drmcnelson/TCD1304-Sensor-Device-with-Linear-Response-and-16-Bit-Differential-ADC/Images/Analog_RedLED_4.0V_SH0.2usec_ICG2.6usec_0pulses.260106.carryover.jpg

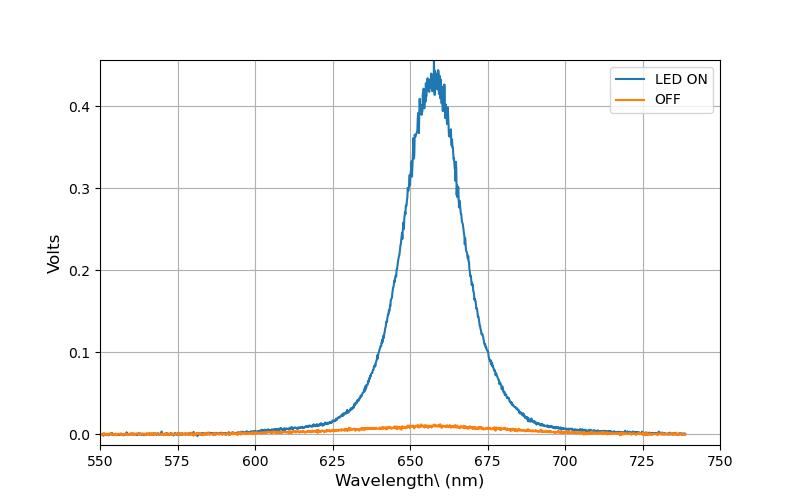
Images/Analog_RedLED_4.0V_SH0.2usec_ICG2.6usec_0pulses.260106.carryover.jpg
