drmcnelson/TCD1304-Sensor-Device-with-Linear-Response-and-16-Bit-Differential-ADC/Images/BJT_followers_Cload_Switched_Curves_Xd-out.jpg

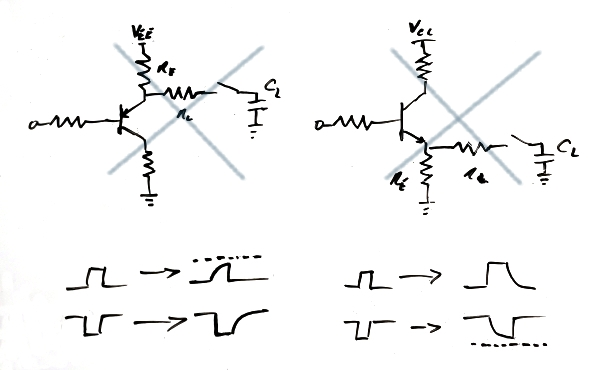
Images/BJT_followers_Cload_Switched_Curves_Xd-out.jpg
