drmcnelson/TCD1304-Sensor-Device-with-Linear-Response-and-16-Bit-Differential-ADC/Images/Carryover_pulse_voltage_all.jpg

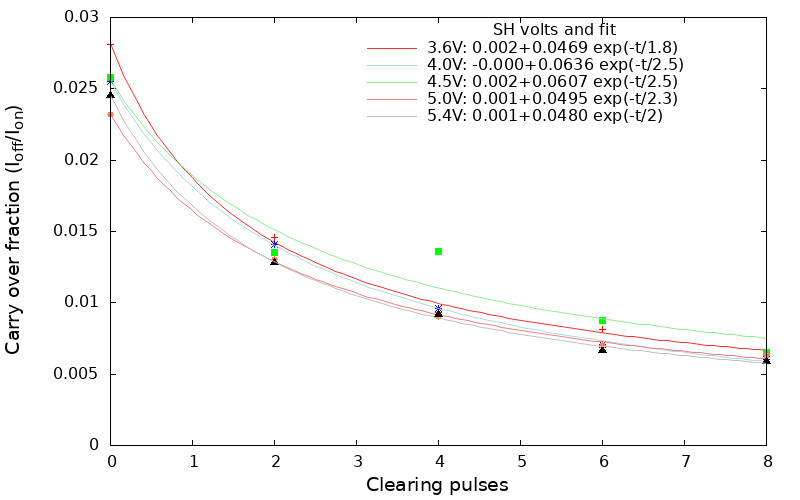
Images/Carryover_pulse_voltage_all.jpg
