drmcnelson/TCD1304-Sensor-Device-with-Linear-Response-and-16-Bit-Differential-ADC/Images/CarryOver_PulseWidth.jpg

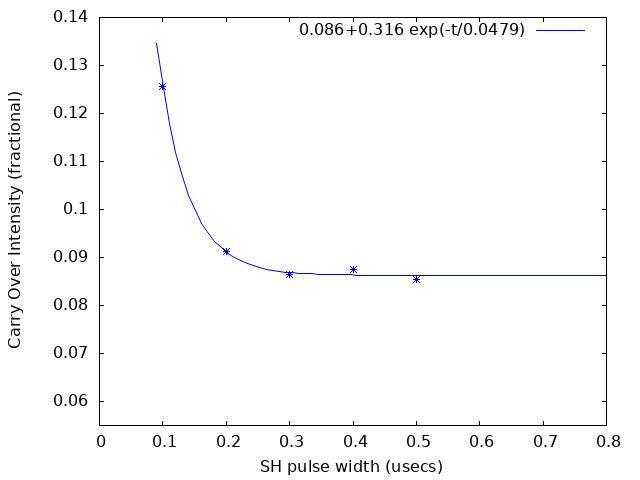
Images/CarryOver_PulseWidth.jpg
