drmcnelson/TCD1304-Sensor-Device-with-Linear-Response-and-16-Bit-Differential-ADC/Images/Carryover_time_voltage.jpg

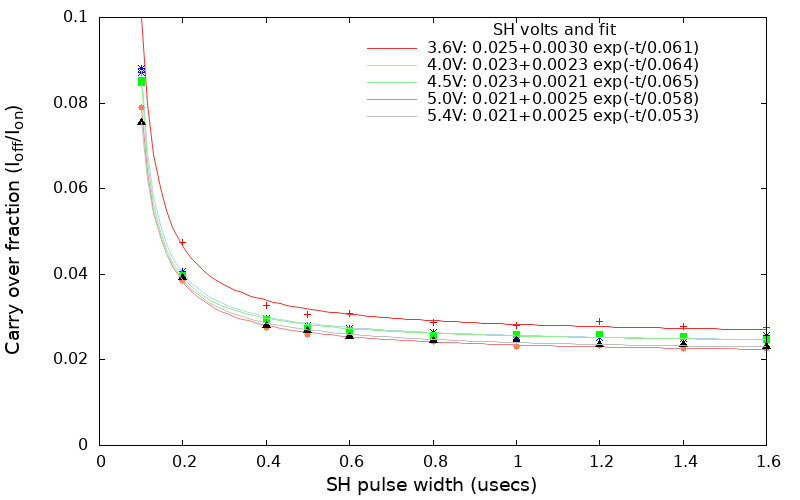
Images/Carryover_time_voltage.jpg
