drmcnelson/TCD1304-Sensor-Device-with-Linear-Response-and-16-Bit-Differential-ADC/Images/CCD-4cycle-diagram.jpg

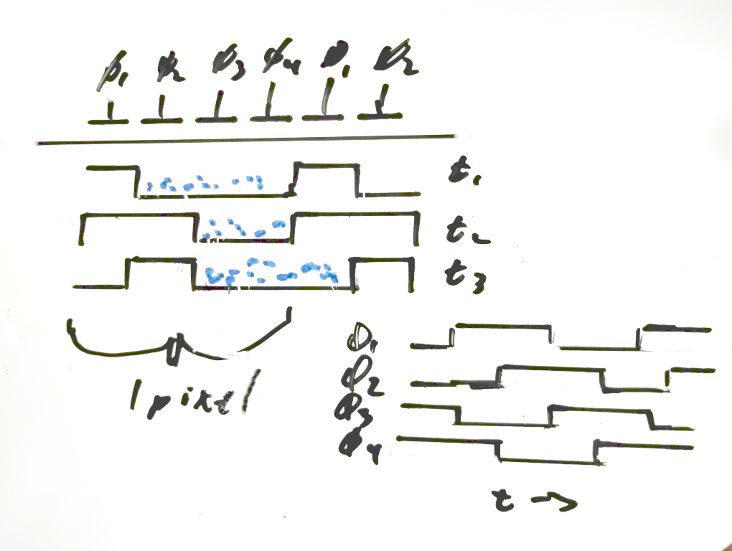
Images/CCD-4cycle-diagram.jpg
