drmcnelson/TCD1304-Sensor-Device-with-Linear-Response-and-16-Bit-Differential-ADC/Images/Comparison_responses_all.jpg

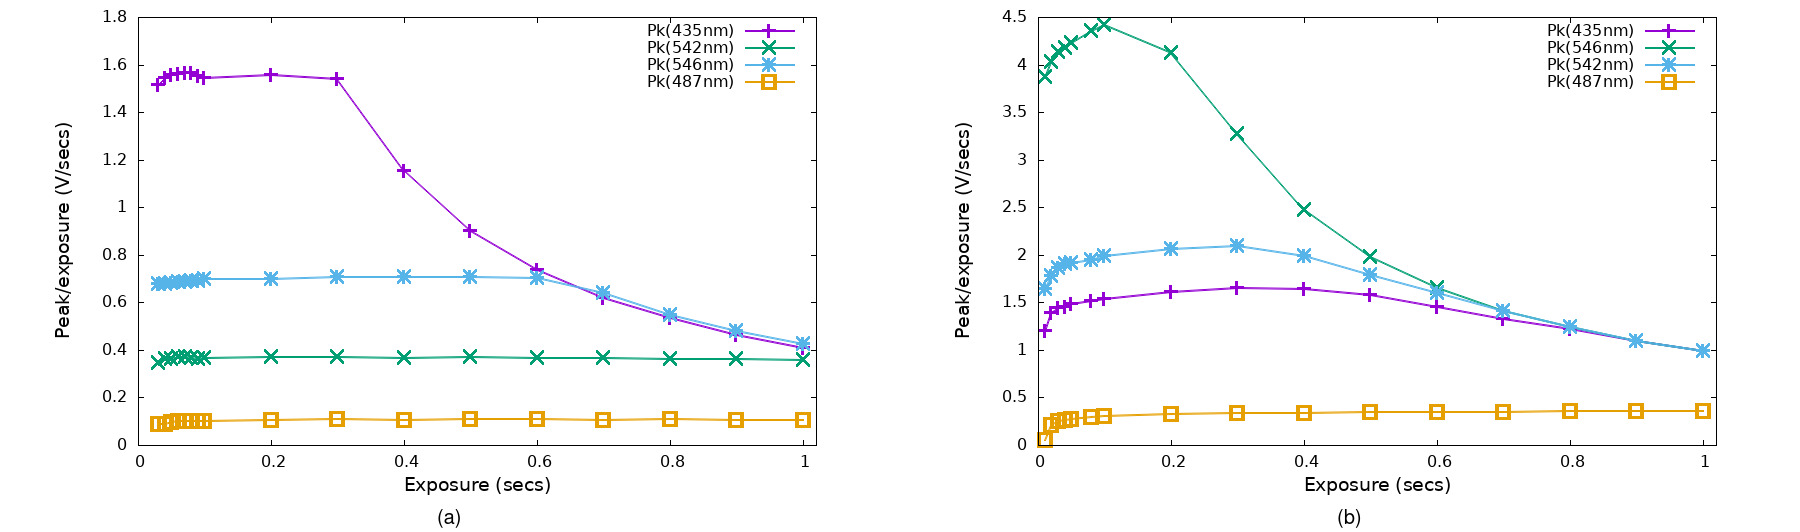
Images/Comparison_responses_all.jpg
