drmcnelson/TCD1304-Sensor-Device-with-Linear-Response-and-16-Bit-Differential-ADC/Images/Comparison_TCD1304_ND1200_Flame-S_ND1500_peaks_ratios542nm_1sec.jpg

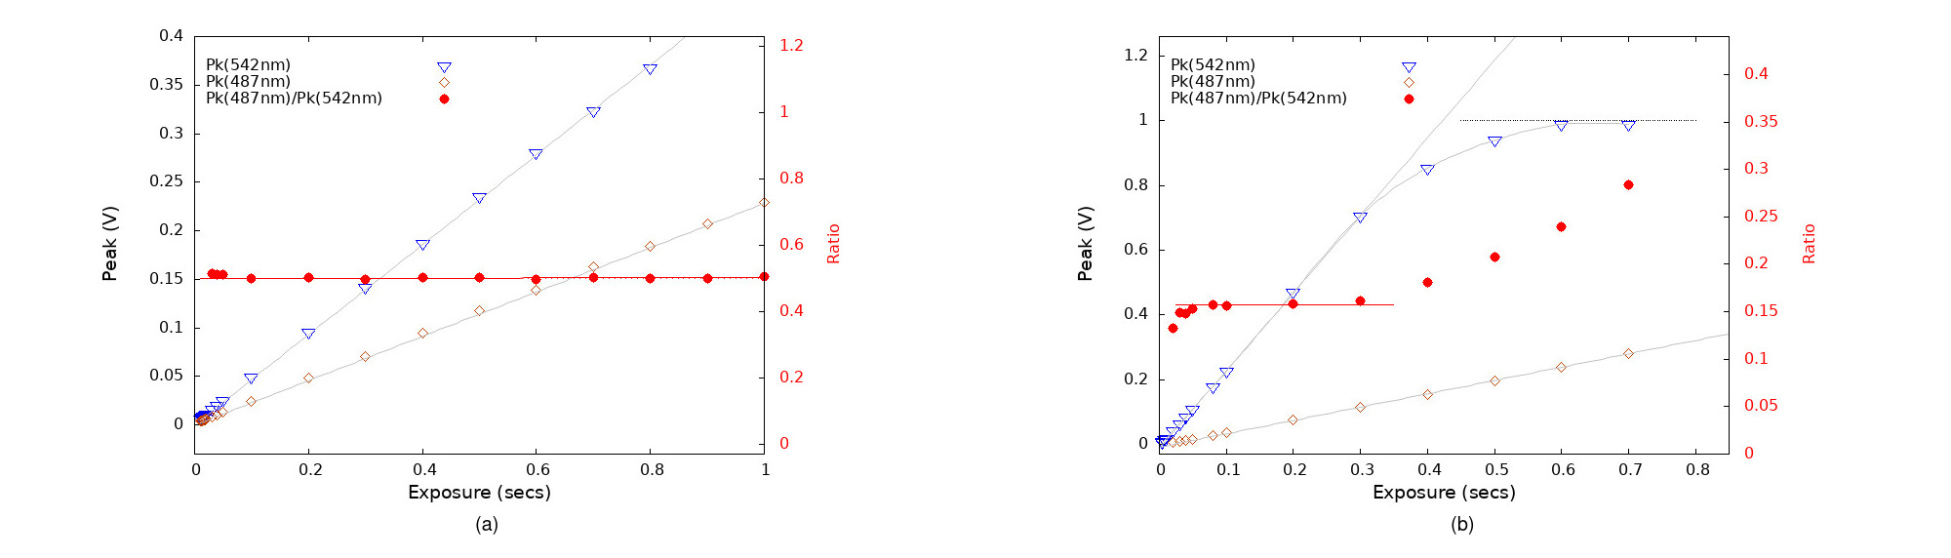
Images/Comparison_TCD1304_ND1200_Flame-S_ND1500_peaks_ratios542nm_1sec.jpg
