drmcnelson/TCD1304-Sensor-Device-with-Linear-Response-and-16-Bit-Differential-ADC/Images/DarkN810_PIT_CLK1e-06sec_CP10_3.jpg

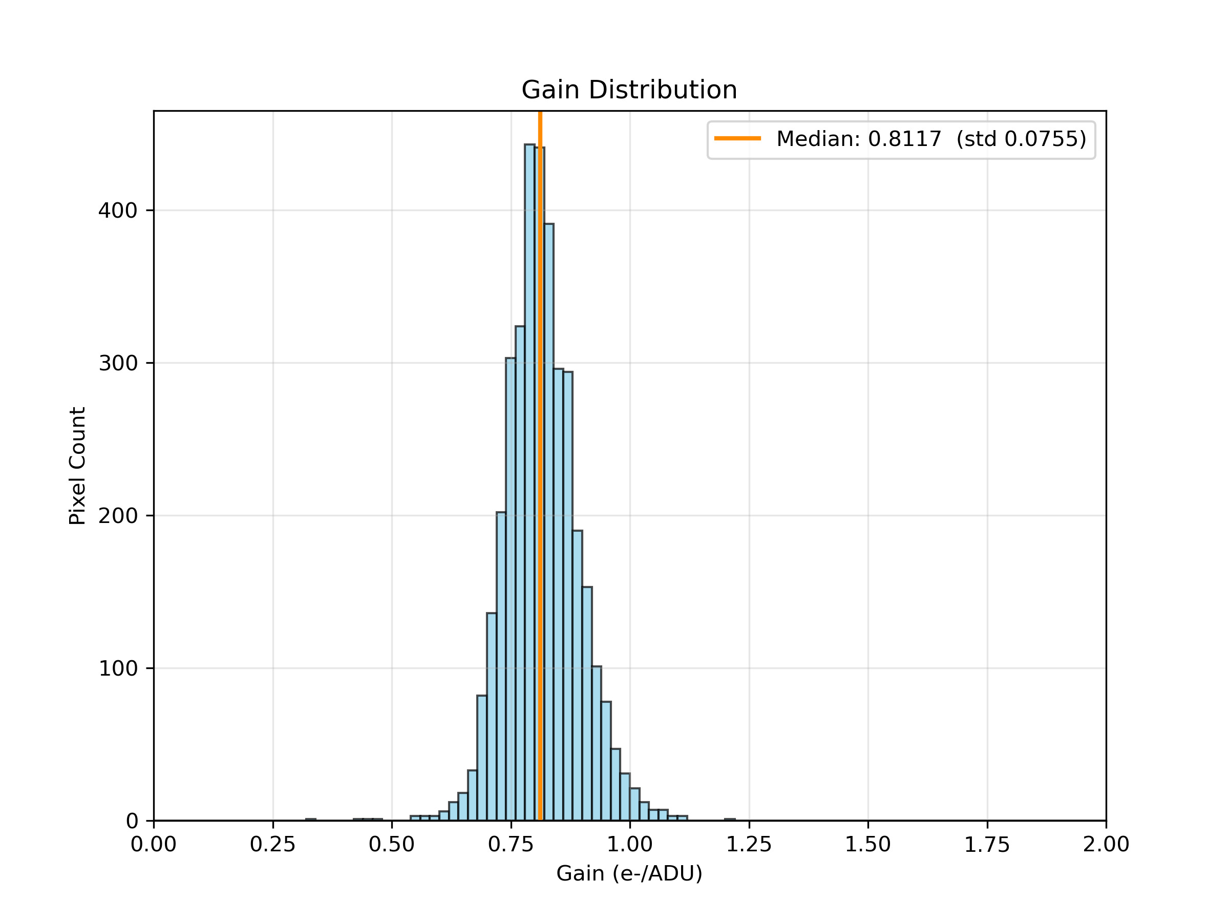
Images/DarkN810_PIT_CLK1e-06sec_CP10_3.jpg
