drmcnelson/TCD1304-Sensor-Device-with-Linear-Response-and-16-Bit-Differential-ADC/Images/DeskLamp_ND12oclock_0.05secs.seabreeze.raw.jpg

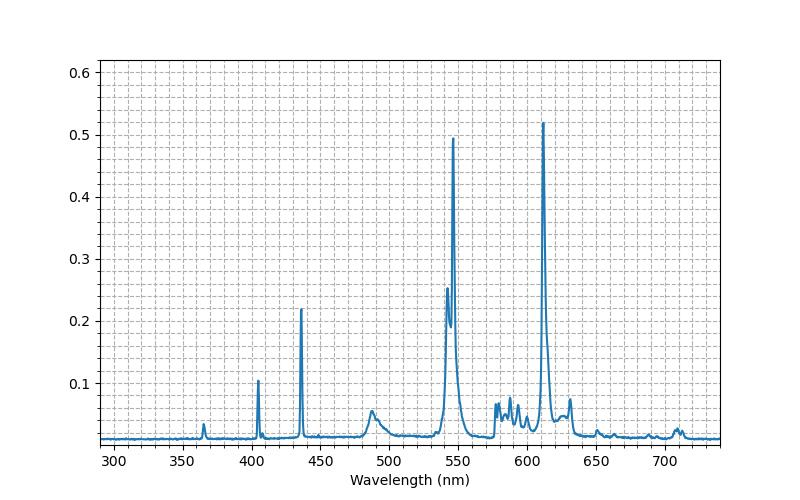
Images/DeskLamp_ND12oclock_0.05secs.seabreeze.raw.jpg
