drmcnelson/TCD1304-Sensor-Device-with-Linear-Response-and-16-Bit-Differential-ADC/Images/Fl_0.02s_frameset64.20250710.101229.398269.lccd.raw.jpg

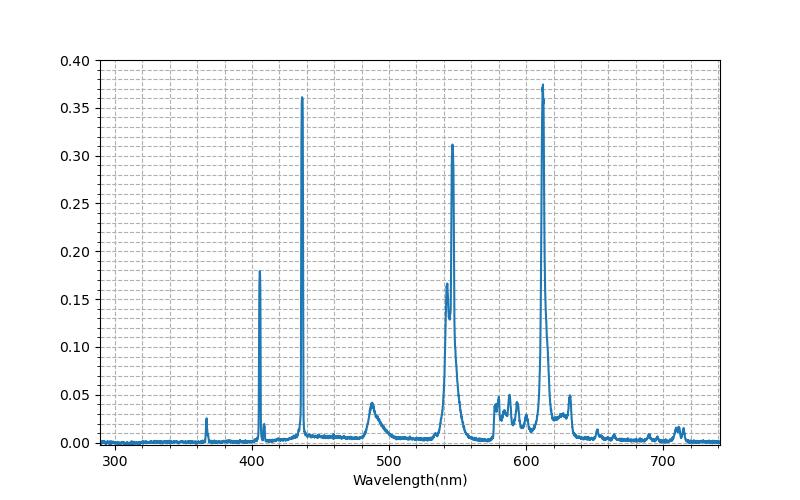
Images/Fl_0.02s_frameset64.20250710.101229.398269.lccd.raw.jpg
