drmcnelson/TCD1304-Sensor-Device-with-Linear-Response-and-16-Bit-Differential-ADC/Images/Flame-S/Flame-S_ND1500_Selected3.png

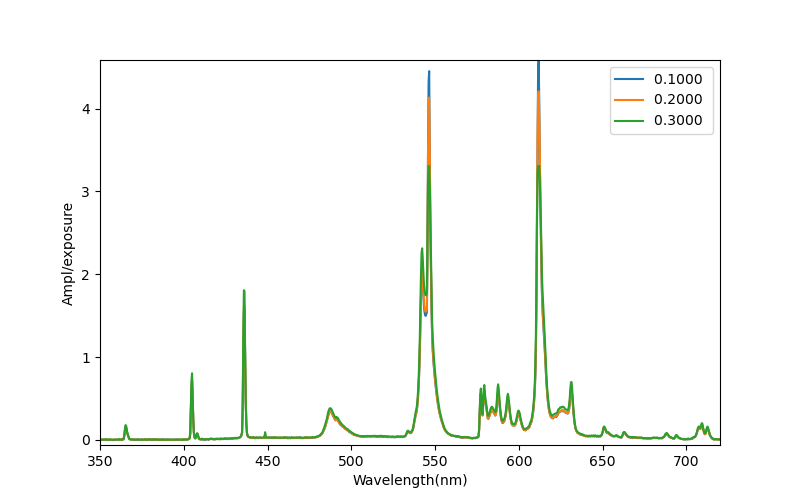
Images/Flame-S/Flame-S_ND1500_Selected3.png
