drmcnelson/TCD1304-Sensor-Device-with-Linear-Response-and-16-Bit-Differential-ADC/Images/Flame-S_ND3oclock_all.ratios_normalized.png

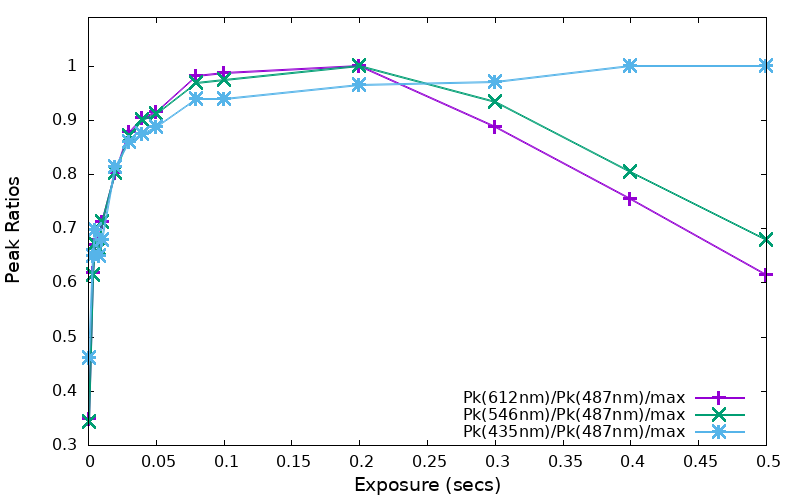
Images/Flame-S_ND3oclock_all.ratios_normalized.png
