drmcnelson/TCD1304-Sensor-Device-with-Linear-Response-and-16-Bit-Differential-ADC/Images/GreenLED_PLM_CLK6e-07sec_to_0.5sec_N110.linearity_min_adu2000_3.jpg

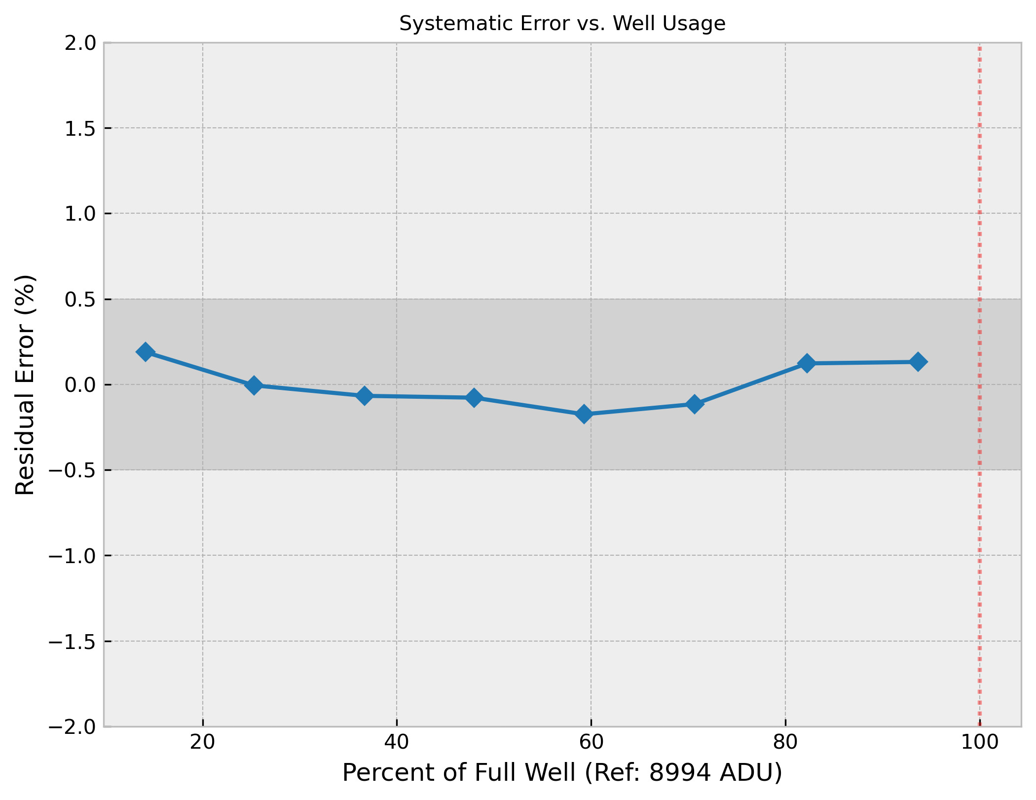
Images/GreenLED_PLM_CLK6e-07sec_to_0.5sec_N110.linearity_min_adu2000_3.jpg
