drmcnelson/TCD1304-Sensor-Device-with-Linear-Response-and-16-Bit-Differential-ADC/Images/LinearResponseComparison.jpg

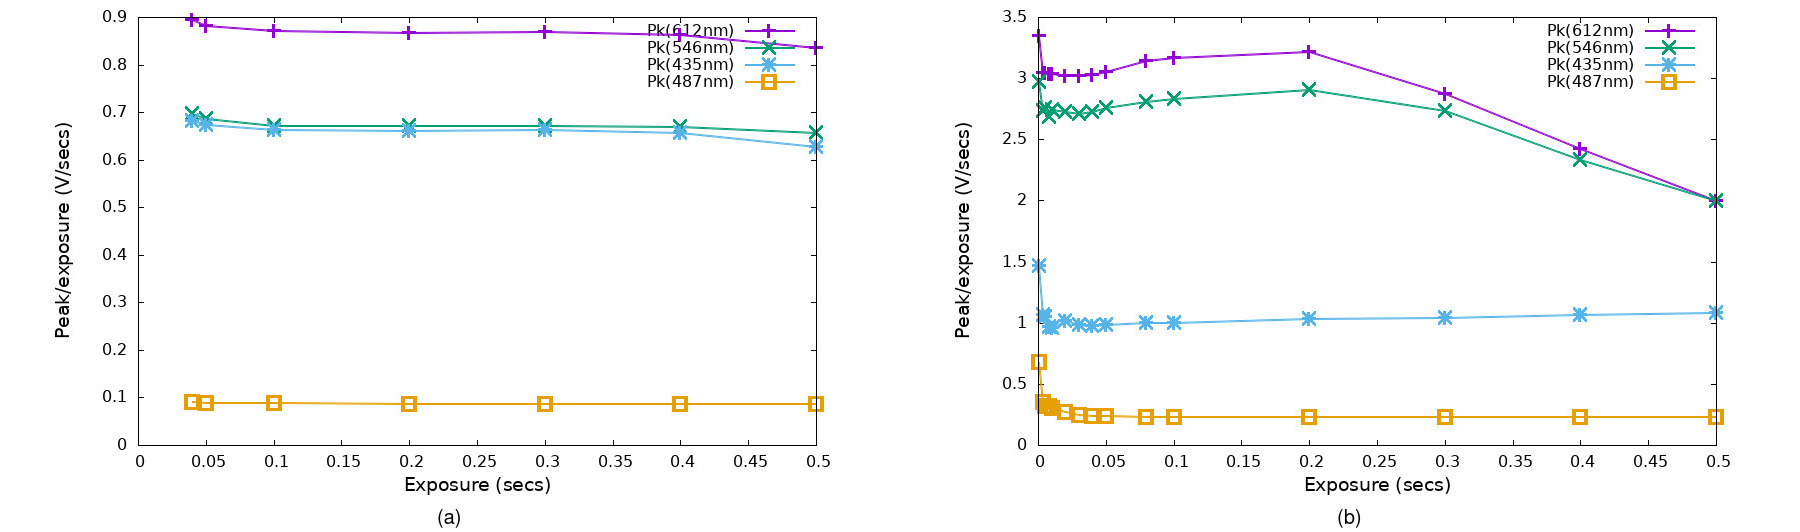
Images/LinearResponseComparison.jpg
