drmcnelson/TCD1304-Sensor-Device-with-Linear-Response-and-16-Bit-Differential-ADC/Images/PeakRatioseComparison.jpg

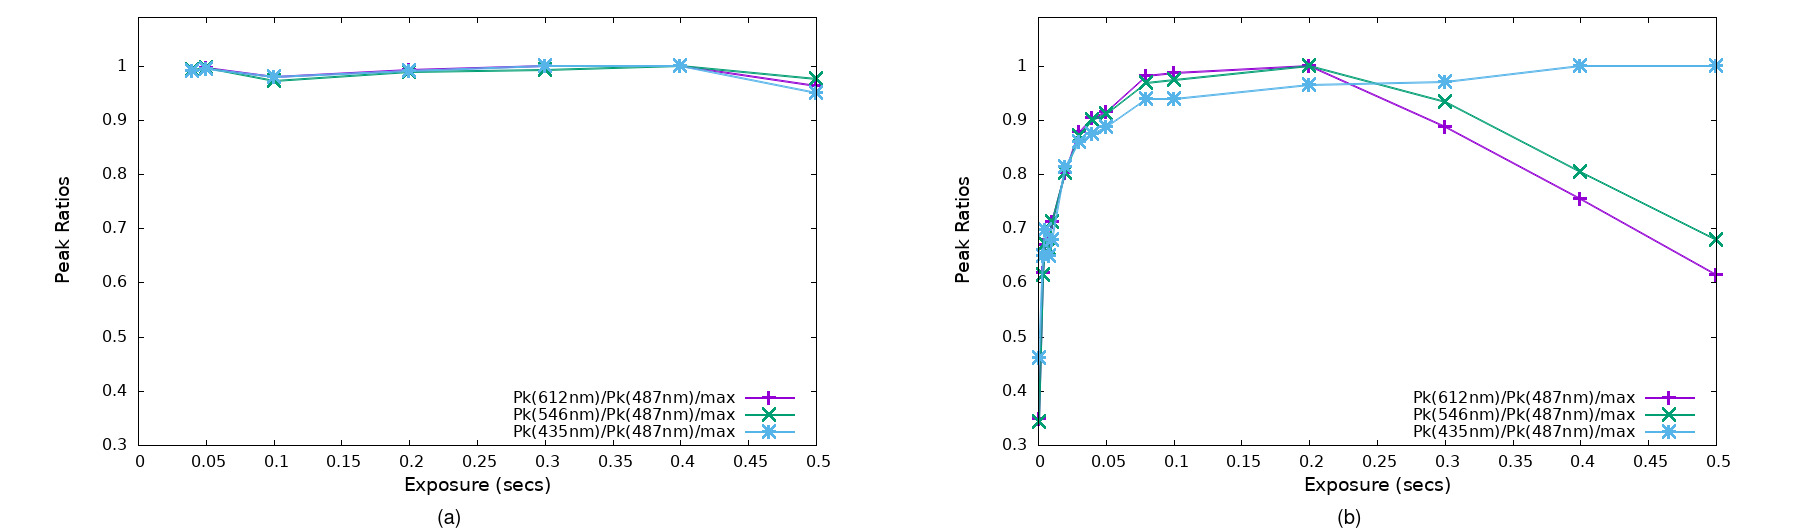
Images/PeakRatioseComparison.jpg
