drmcnelson/TCD1304-Sensor-Device-with-Linear-Response-and-16-Bit-Differential-ADC/Images/pulsewidth_study_0.2us.20250918.131309.022768.lccd.jpg

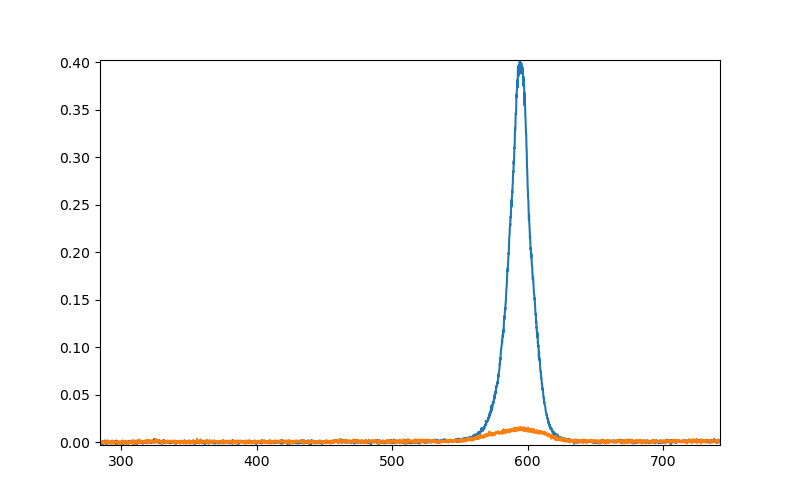
Images/pulsewidth_study_0.2us.20250918.131309.022768.lccd.jpg
