drmcnelson/TCD1304-Sensor-Device-with-Linear-Response-and-16-Bit-Differential-ADC/Images/Ringing_SensorScale_260127.jpg

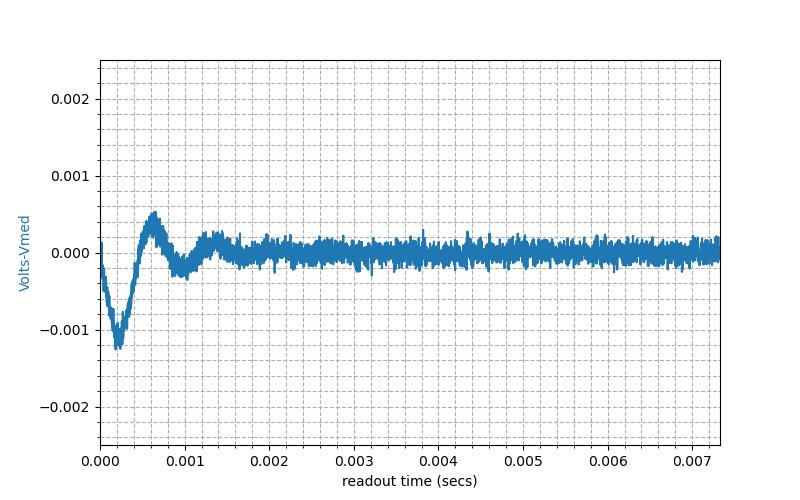
Images/Ringing_SensorScale_260127.jpg
