drmcnelson/TCD1304-Sensor-Device-with-Linear-Response-and-16-Bit-Differential-ADC/Images/RinginGone_clk0.6usec_SensorScale_260415.jpg

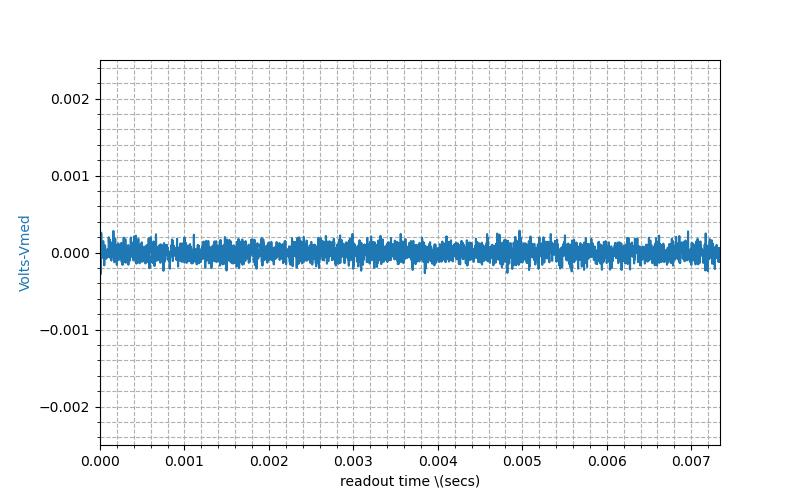
Images/RinginGone_clk0.6usec_SensorScale_260415.jpg
