drmcnelson/TCD1304-Sensor-Device-with-Linear-Response-and-16-Bit-Differential-ADC/Images/Spectrum_Flip_Shift_RC_SAR.jpg

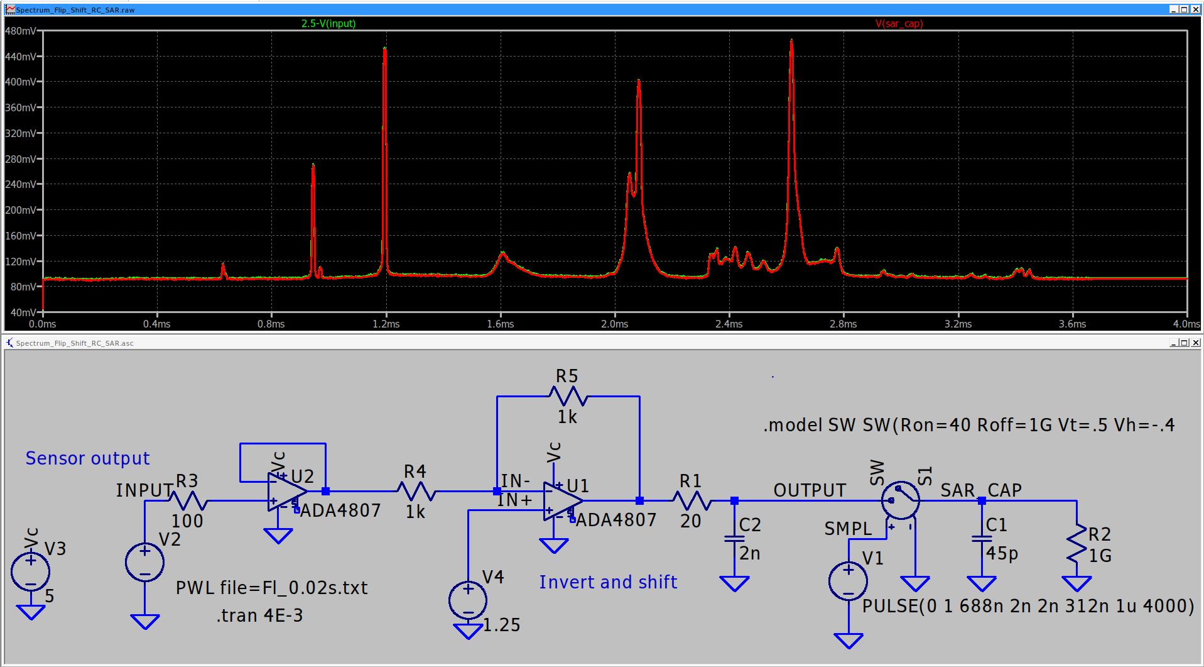
Images/Spectrum_Flip_Shift_RC_SAR.jpg
