drmcnelson/TCD1304-Sensor-Device-with-Linear-Response-and-16-Bit-Differential-ADC/Images/TCD1304_Fluorescent_ND0400.raw_peaks_ratios546nm_0.001sec.jpg

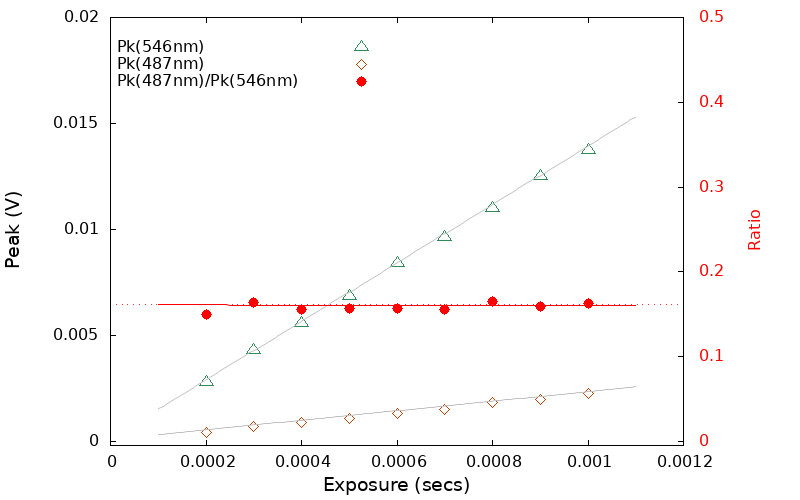
Images/TCD1304_Fluorescent_ND0400.raw_peaks_ratios546nm_0.001sec.jpg
