drmcnelson/TCD1304-Sensor-Device-with-Linear-Response-and-16-Bit-Differential-ADC/Images/TCD1304_ND12oclock_timer_all.ratios_normalized.png

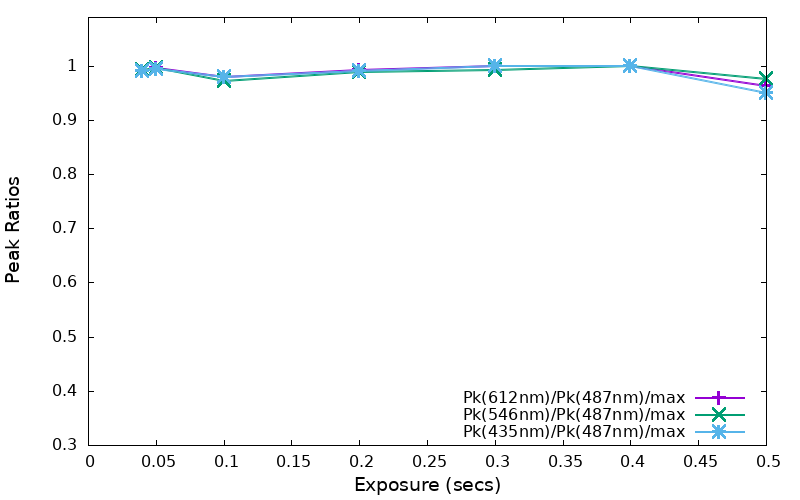
Images/TCD1304_ND12oclock_timer_all.ratios_normalized.png
