drmcnelson/TCD1304-Sensor-Device-with-Linear-Response-and-16-Bit-Differential-ADC/Images/TCD1304DG_E_250219-06.jpg

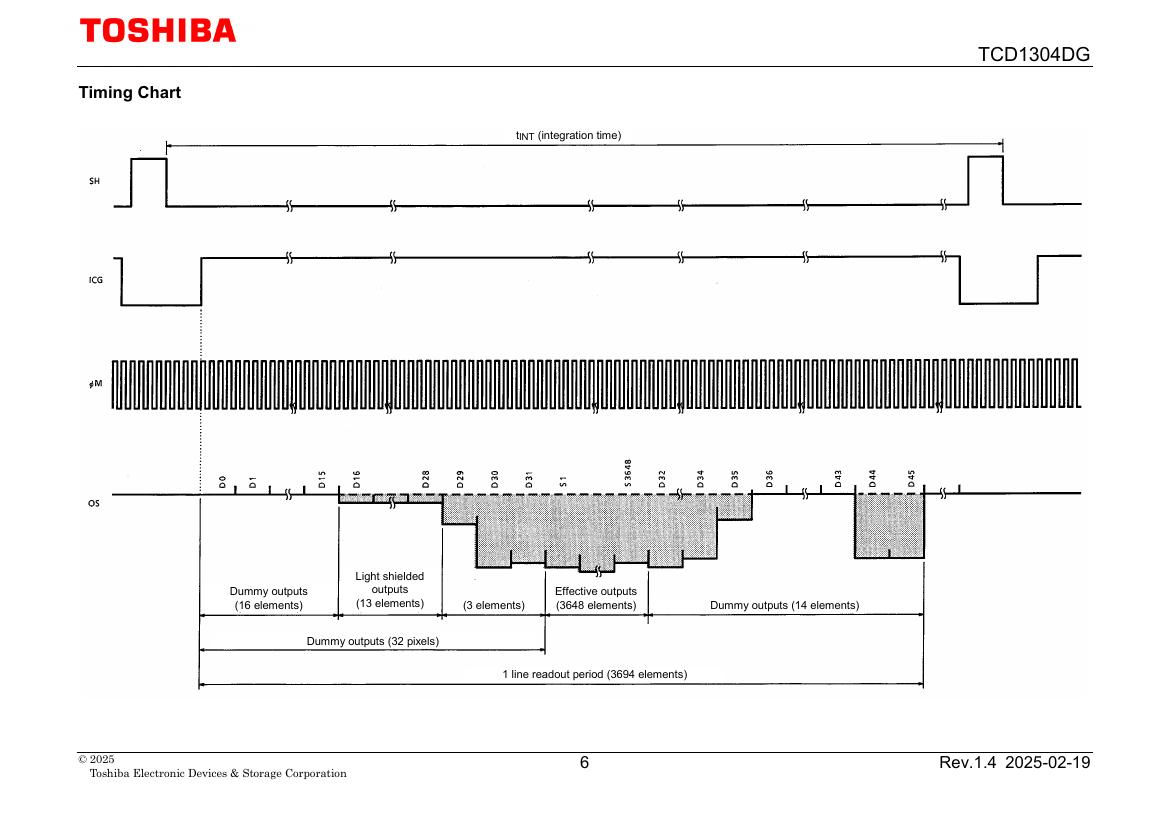
Images/TCD1304DG_E_250219-06.jpg
