drmcnelson/TCD1304-Sensor-Device-with-Linear-Response-and-16-Bit-Differential-ADC/Images/TheNewInstrument/TheNewSpectrometer_overlays.png

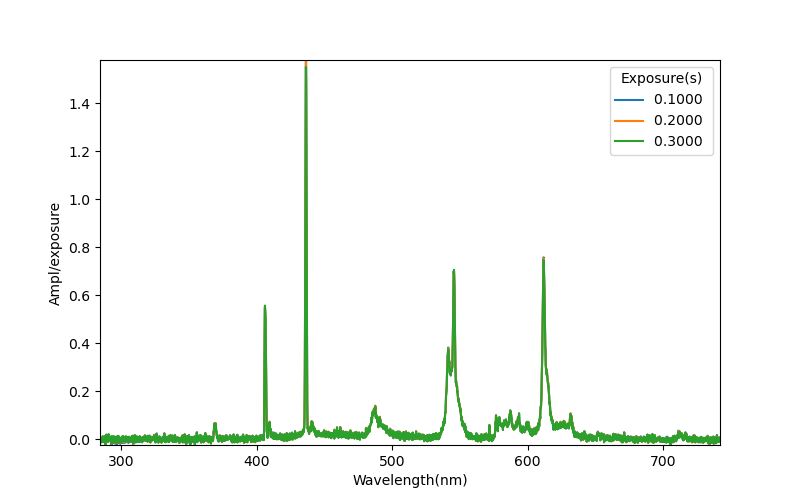
Images/TheNewInstrument/TheNewSpectrometer_overlays.png
