drmcnelson/TCD1304-Sensor-Device-with-Linear-Response-and-16-Bit-Differential-ADC/TCD1304_Analog/TCD1304_Analog_BOM.xls

Reference | Value | Footprint | Qty | DNP | Description | Digikey | Accessory Part
C1,C17 | 1uf | Capacitor_SMD:C_0603_1608Metric | 2 |  | Cap Cer 1uF, 10%, 16V, X7R | 399-17704-1-ND
C2,C3,C5,C7,C8,C11,C12,C13 | 0.1uF | Capacitor_SMD:C_0603_1608Metric | 8 |  | Cap Cer 0.1uF, 10%, 16V, X7R | 399-6856-1-ND
C4,C6,C10,C14,C15,C16 | 10uf | Capacitor_SMD:C_0805_2012Metric | 6 |  | Cap Cer 10uF, 10%, 25V, X5R | 399-11939-1-ND
C9 | 2p | Capacitor_SMD:C_0603_1608Metric | 1 |  | Cap Cer 2pF, 5%, 50V, C0G/NPO | 311-3077-1-ND
C18 | 10nF | Capacitor_SMD:C_0603_1608Metric | 1 |  | Cat Cer 10nf, 5%, 25V X7R | 399-C0603C103J3RACAUTOCT-ND
C19 | 4.7uF | Capacitor_SMD:C_0805_2012Metric_Pad1.18x1.45mm_HandSolder | 1 |  | Cap Cer 4.7uF, 5%, 25V X7R | 399-C0805C475J3RACAUTOCT-ND
J1,J2 | Conn_01x02_Pin | Connector_PinHeader_2.54mm:PinHeader_1x02_P2.54mm_Vertical | 2 |  | Generic connector, single row, 01x02, script generated
J3 | Conn_01x04_Pin | Connector_PinHeader_2.54mm:PinHeader_1x04_P2.54mm_Vertical | 1 |  | Generic connector, single row, 01x04, script generated
J4 | 705430001 | MOLEX_705430001 | 1 |  | Molex 2 pin keyed 2.54mm pitch connector | WM4800-ND
JP1 | Jumper_2_Open | Jumper:SolderJumper-2_P1.3mm_Bridged_Pad1.0x1.5mm | 1 |  | Jumper, 2-pole, open
R1,R2 | 100 | Resistor_SMD:R_0603_1608Metric | 2 |  | Res 100 ohm, 1%, 1/4W | 541-2786-1-ND
R3 | 499R | Resistor_SMD:R_0603_1608Metric | 1 |  | RES 499 OHM 1% 1/8W 0603 | 2019-RK73H1JTTD4990FCT-ND
R4 | 2.49K | Resistor_SMD:R_0603_1608Metric | 1 |  | RES 2.49K OHM 1% 1/10W 0603 | 311-2.49KHRCT-ND
R5,R8 | 200 | Resistor_SMD:R_0805_2012Metric_Pad1.20x1.40mm_HandSolder | 3 |  | Res 200 ohm, 1%, 1/2W, pulse withstanding | P16064CT-ND
R7 | 100 | Resistor_SMD:R_0805_2012Metric_Pad1.20x1.40mm_HandSolder | 1 |  | Res 100 ohm, 1%, 1/2W, pulse withstanding | P16057CT-ND
RV1 | 10K | Potentiometer_THT:Potentiometer_Bourns_3296W_Vertical | 1 |  | TRIMMER 10K OHM 0.5W PC PIN TOP | 118-3296W-1-103RLFCT-ND
U1 | TCD1304AP | Package_DIP:DIP-22_W10.16mm_Socket | 1 |  | CONN IC DIP SOCKET 22POS GOLD | ED90039-ND
U1b1 | TCD1304AP-sensor | DIP1016W47P254L4210H372Q22 | 1 |  | CCD LINEAR IMAGE SENSOR WDIP22 | 264-TCD1304DG(8ZK)-ND
U2,U3 | ADA4807-1 | Package_TO_SOT_SMD:SOT-23-6 | 2 |  | Single Rail-to-Rail Input/Output Amplifiers, with disable, SC-70-6/SOT-23-6 | 505-ADA4807-1ARJZ-R7CT-ND
U4,U5,U6 | 74LVC1G34 | Package_TO_SOT_SMD:SOT-23-5 | 3 |  | Single Buffer Gate, Low-Voltage CMOS | 296-17893-1-ND
U7 | LP2985-3.3 | Package_TO_SOT_SMD:SOT-23-5 | 1 |  | 150mA 16V Low-noise Low-dropout Regulator With Shutdown, 3.3V output voltage, SOT-23-5 | 296-18476-1-ND
 |  |  |  |  | Breakaway headers stick | 952-3307-ND
