drmcnelson/TCD1304-Sensor-Device-with-Linear-Response-and-16-Bit-Differential-ADC/TCD1304_SPI_Rev2EB/TCD1304_SPI_Rev2EB_BOM250620.xls

Reference | Value | Footprint | Qty | DNP | Description | Digikey | Accessory Part
C1,C2,C4,C5,C9,C10,C13,C15,C19,C21,C23,C24,C29,C39,C41 | 0.1uF | Capacitor_SMD:C_0603_1608Metric | 15 |  | Cap Cer 0.1uF, 10%, 16V, X7R | 399-6856-1-ND
C3,C34 | 22uf | Capacitor_SMD:C_0805_2012Metric_Pad1.18x1.45mm_HandSolder | 2 |  | Cap Cer 22uF, 10%, 16V, X5R | 490-12389-1-ND
C6,C12,C16,C17,C18,C22,C37 | 1uf | Capacitor_SMD:C_0603_1608Metric | 7 |  | Cap Cer 1uF, 10%, 16V, X7R | 399-17704-1-ND
C7,C36 | 0.01uf | Capacitor_SMD:C_0603_1608Metric | 2 |  | Cap Cer 0.01 uF, 10%, 25V, X7R | 399-6851-1-ND
C8,C14,C20,C25,C38,C40 | 10uf | Capacitor_SMD:C_0805_2012Metric | 6 |  | Cap Cer 10uF, 10%, 25V, X5R | 399-11939-1-ND
C11 | 2p | Capacitor_SMD:C_0402_1005Metric | 1 |  | Cap Cer 2pF, 5%, 16V, C0G/NPO | 399-CBR04C209B5GACCT-ND
C26 | 100pf | Capacitor_SMD:C_0603_1608Metric | 1 |  | Cap Cer 100pF, 10%, 50V, X7R | 399-17391-1-ND
C27,C28 | 20pf | Capacitor_SMD:C_0603_1608Metric | 2 |  | Cap Cer 20pF,. 1%, 50V, C0G/NP0 | 478-10299-1-ND
C30,C33 | 0.1uF | Capacitor_SMD:C_0402_1005Metric_Pad0.74x0.62mm_HandSolder | 2 |  | Cap Cer 0.1uF, 10%, 16V, X7R | 399-6828-1-ND
C31,C32 | 1.2nf | Capacitor_SMD:C_0603_1608Metric_Pad1.08x0.95mm_HandSolder | 2 |  | Cap Cer 1.2nf, 1%, C0G/NPO | 490-GCM1885C1H122FA16DCT-ND
C35 | 0.22uf | Capacitor_SMD:C_0603_1608Metric | 1 |  | CAP CER 0.22UF 16V X7R 0402 | 399-6875-1-ND
D1 | 1N5819 | Diode_SMD:D_SOD-123 | 1 |  | DIODE SCHOTTKY 40V 1A SOD123 | 1N5819HW-FDICT-ND
IC1,IC2,IC4 | 74LVC1T45GW,125 | 74LVC1T45GW_125:SOT65P210X110-6N | 3 |  | 74LVC1T45; 74LVCH1T45 - Dual supply translating transceiver; 3-state@en-us | 1727-4560-1-ND
IC5 | THS4521IDR | Package_SO:SOIC-8_3.9x4.9mm_P1.27mm | 1 |  | RAIL-TO-RAIL OUTPUT, FULLY DIFFERENTIAL AMPLIFIER | 296-39226-1-ND
IC6 | MCP33131D-10-x_MS | Package_SO:MSOP-10_3x3mm_P0.5mm | 1 |  | 16-bit, 1 Msps, single channel, differential SAR ADC | MCP33131D-10-E/MS-ND
J1 | 705430001 | MOLEX_705430001 | 1 |  | CONN HEADER VERT 2POS 2.54MM | WM4800-ND
J3 | Conn_02x10_Odd_Even | Connector_IDC:IDC-Header_2x10_P2.54mm_Vertical | 1 |  | CONN HEADER VERT 20POS 2.54MM | ED10524-ND
JP1 | Jumper_2_Open | Connector_PinHeader_1.27mm:PinHeader_1x02_P1.27mm_Vertical | 1 |  | Jumper, 2-pole, open | S9014E-02-ND | S9345-ND
L1 | 10uH | Inductor_SMD:L_Taiyo-Yuden_NR-40xx | 1 |  | FIXED IND 10UH 1.2A 180 MOHM SMD | 587-2886-1-ND
R1,R6 | 100 | Resistor_SMD:R_0603_1608Metric | 2 |  | Res 100 ohm, 1%, 1/4W | 541-2786-1-ND
R2 | 200 | Resistor_SMD:R_0805_2012Metric_Pad1.20x1.40mm_HandSolder | 1 |  | Res 200 ohm, 1%, 1/2W, pulse withstanding | P16064CT-ND
R3,R5 | 82 | Resistor_SMD:R_0805_2012Metric_Pad1.20x1.40mm_HandSolder | 2 |  | Res 82 ohm, 1%, 1/2W, pulse withstanding | 10-ERJ-UP6F82R0VCT-ND
R4,R7 | 2.00K | Resistor_SMD:R_0402_1005Metric | 2 |  | Res 2K 0.1%, 1/10W | P2.0KDCDKR-ND
R8,R11,R20,R25 | 49.9R | Resistor_SMD:R_0603_1608Metric | 4 |  | Res 49.9ohm, 1%, 1/10W | RMCF0603FT49R9CT-ND
R9,R10 | 499 | Resistor_SMD:R_0603_1608Metric | 2 |  | 0.1%, 1/10W, can be 400 to 500 ohms | P499DBCT-ND
R12,R13 | 2.49K | Resistor_SMD:R_0603_1608Metric | 2 |  | 0.1%, 1/10W | P2.49KDBCT-ND
R14 | 10K | Resistor_SMD:R_0603_1608Metric | 1 |  | Res 10K, 1%, 1/10W | 541-10.0KHCT-ND
R15 | 30K | Resistor_SMD:R_0603_1608Metric | 1 |  | Res 30K, 1%, 1/10W | RMCF0603FT30K0CT-ND
R16,R17 | 24.9R | Resistor_SMD:R_0603_1608Metric_Pad0.98x0.95mm_HandSolder | 2 |  | Res 24.9 ohm, 1%, 1/4W | 846-ESR03EZPF24R9CT-ND
R18,R19 | 4.99K | Resistor_SMD:R_0603_1608Metric | 2 |  | Res 5K 0.1%, 1/10W | P4.99KDBCT-ND
R21,R23 | 30.1k | Resistor_SMD:R_0603_1608Metric | 2 |  | Res 30.1k, 0.1%, 1/16W | P30.1KDBCT-ND
R22,R24 | 13k | Resistor_SMD:R_0603_1608Metric | 2 |  | Res 13.0k, 0.1%, 1/16W | P13KDBCT-ND
RV1 | 10K | Potentiometer_THT:Potentiometer_Bourns_3296W_Vertical | 1 |  | TRIMMER 10K OHM 0.5W PC PIN TOP | 118-3296W-1-103RLFCT-ND
U1 | TCD1304AP | DIP1016W47P254L4210H372Q22 | 1 |  | CONN IC DIP SOCKET 22POS GOLD | ED90039-ND
U2 | ADA4807-2ARM | Package_SO:MSOP-8_3x3mm_P0.65mm | 1 |  | Dual Rail-to-Rail Input/Output Amplifiers, MSOP-8 | ADA4807-2ARMZ-R7CT-ND
U3 | TPS72218 | Package_TO_SOT_SMD:SOT-23-5 | 1 |  | .18V linear regulator | 296-12523-1-ND
U4 | ADR4540 | Package_SO:SOIC-8_3.9x4.9mm_P1.27mm | 1 |  | 4.096V, Ultralow Noise, High Accuracy Voltage Reference, SOIC-8 | ADR4540ARZ-R7CT-ND
U5,U6 | LT1761-BYP | Package_TO_SOT_SMD:TSOT-23-5 | 2 |  | MICROPOWER 100mA LDO adjustable regulator, TSOT-23-5 | 505-LT1761ES5-BYP#TRMPBFCT-ND
U5b1 | TCD1304AP-sensor | DIP1016W47P254L4210H372Q22 | 1 |  | CCD LINEAR IMAGE SENSOR WDIP22 | 264-TCD1304DG(8ZK)-ND
