drmcnelson/TCD1304-Sensor-Device-with-Linear-Response-and-16-Bit-Differential-ADC/TCD1304_All-In-One_FlexPWM/TCD1304_All-in-One_FlexPWM_BOM.xls

Reference | Value | Footprint | Qty | DNP | Description | Digikey | Newark | Mouser
C1,C3,C6,C8,C10,C11 | 10uF | Capacitor_SMD:C_0603_1608Metric | 6 |  | CAP CER 10UF 16V X7R 0603 10% | 490-12317-1-ND | 66AJ7194
C2,C4,C9 | 0.1uF | Capacitor_SMD:C_0603_1608Metric | 3 |  | CAP CER 0.1UF 16V X7R 0603 10% | 399-C0603X104J3RACAUTOCT-ND | 94M5632
C5 | 2p | Capacitor_SMD:C_0603_1608Metric | 1 |  | CAP CER 2PF 250V C0G/NP0 0603 5% | 1284-1196-1-ND | 80AK9132
C7 | 68p | Capacitor_SMD:C_0603_1608Metric | 1 | DNP | CAP CER 68PF 50V C0G/NP0 0603 5% | 1276-1135-1-ND | 24W7895
D1,D2,D3 | BAV99 | Package_TO_SOT_SMD:SOT-23 | 6 |  | DIODE ARR GP 100V 215MA TO236AB | 1727-2914-1-ND | 03AC7812
J1 | Conn_01x08_Male | Connector_PinHeader_2.54mm:PinHeader_1x08_P2.54mm_Vertical | 1 |  | CONN HEADER VERT 8POS 2.54MM | 3M156268-08-ND
J2 | Conn_01x16_Male | Connector_PinHeader_2.54mm:PinHeader_1x16_P2.54mm_Vertical | 1 |  | CONN HEADER VERT 16POS 2.54MM | 3M156268-16-ND
R1,R4 | 100R | Resistor_SMD:R_0603_1608Metric | 2 |  | RES 100 OHM 1% 1/10W 0603 | 2019-RK73H1JTTD1000FCT-ND | 66F9065
R2 | 499R | Resistor_SMD:R_0603_1608Metric | 1 |  | RES 499 OHM 0.1% 1/10W 0603 | 2019-RK73H1JTTD4990FCT-ND | 13AJ6704
R3 | 2.49K | Resistor_SMD:R_0603_1608Metric | 1 |  | RES 2.49K OHM 0.1% 1/10W 0603 | 311-2.49KHRCT-ND | 70AC2377
R5,R6,R7 | 300R | Resistor_SMD:R_0603_1608Metric | 3 |  | RES 300 OHM 1% 1/10W 0603 | 2019-RK73H1JTTD3000FCT-ND | 82AH8133
R8 | 200R | Resistor_SMD:R_0603_1608Metric_Pad0.98x0.95mm_HandSolder | 1 |  | RES 200 OHM 1% 1/4W 0603 Pulse resistant | 541-10437-1-ND | 65AC3392
R9,R10 | 82R | Resistor_SMD:R_0603_1608Metric_Pad0.98x0.95mm_HandSolder | 2 |  | RES 82 OHM 1% 1/4W 0603 Pulse resistant | A130403CT-ND | 41R4706
R11,R12,R13 | 50 | Resistor_SMD:R_0603_1608Metric_Pad0.98x0.95mm_HandSolder | 3 |  | RES 49.9 OHM 1% 1/4W 0603 | 541-2784-1-ND | 85Y6509
RV1 | 10K | BournsTrimPot_3296W-1-502LF:TRIM_3296W-1-502LF | 1 |  | TRIMMER 10K OHM 0.5W PC PIN TOP | 3296W-103LF-ND | 62J1423
U1 | TCD1304DG | DIP1016W47P254L4210H372Q22 | 1 |  | CONN IC DIP SOCKET 22POS GOLD | ED90039-ND
U2 | ADA4807-2ARMZ-R7 | Package_SO:MSOP-8_3x3mm_P0.65mm | 1 |  | IC VOLTAGE FEEDBACK 2 CIRC 8MSOP | ADA4807-2ARMZ-R7CT-ND | 60AK4543
U3 | Teensy4.0 | teensy_footprints:Teensy40 | 1 |  | Teensy4.0 | 1568-DEV-16997-ND
U4 | 74LVC3G34 | Package_SO:TSSOP-8_4.4x3mm_P0.65mm | 1 |  | Triple Buffer, Low-Voltage CMOS | 1727-6685-1-ND | 74AH2620
U3b | T4_mounting | T4 | 2 |  | Headers to mount the T4, 14 pos 0.1” | S7047-ND
U1b | TCD1304DG | TCD1304 | 1 |  | TCD1304 sensor (check ebay for this) |  |  | 757-TCD1304DG8ZK
