drmcnelson/TCD1304-Sensor-Device-with-Linear-Response-and-16-Bit-Differential-ADC/TCD1304_SPI_Rev2EB/TCD1304_SPI_Rev2EB.step

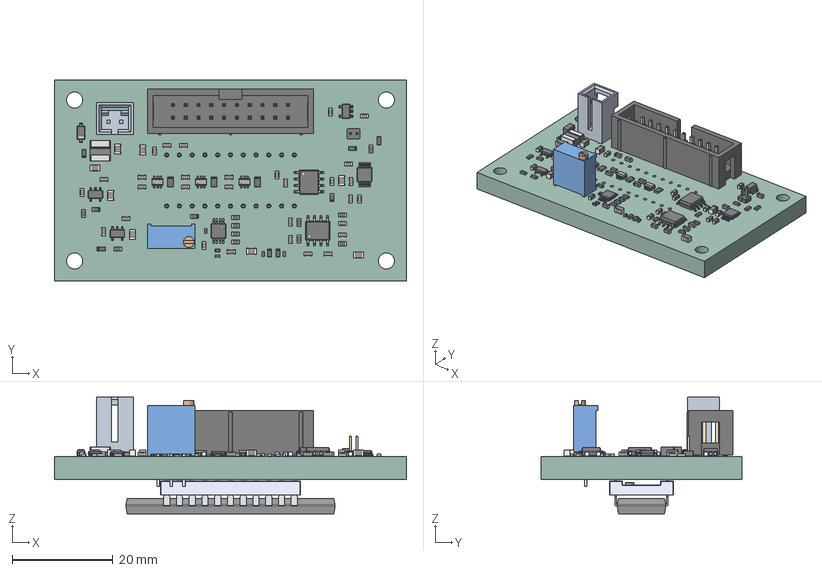
[picture p127: CAD file, 2026-05-04]
TCD1304_SPI_Rev2EB/TCD1304_SPI_Rev2EB.step
70.0 x 40.0 x 23.2 mm
R_0603_1608Metric x 20
TSOT-23-5 x 2
R_0805_2012Metric x 3
C_0805_2012Metric x 8
D_SOD-123
R_0402_1005Metric x 2
MSOP-10_3x3mm_P0.5mm
C_0603_1608Metric x 30
SOT-23-5
PinHeader_1x02_P1.27mm_Vertical
TSSOP6_SOT363-2_NEX x 3
SOIC-8_3.9x4.9mm_P1.27mm x 2
Potentiometer_Bourns_3296W_Vertical
IND_TAIYO_NRS4018_TAY
IDC-Header_2x10_P2.54mm_Vertical
MSOP-8_3x3mm_P0.65mm
C_0402_1005Metric x 3
110-xx-422-41-001000
PinsArrayLR
TCD1304_SPI_EasyBUild_PCB
