drmcnelson/TCD1304-Sensor-Device-with-Linear-Response-and-16-Bit-Differential-ADC/Python/Calibration2/Calibration.png

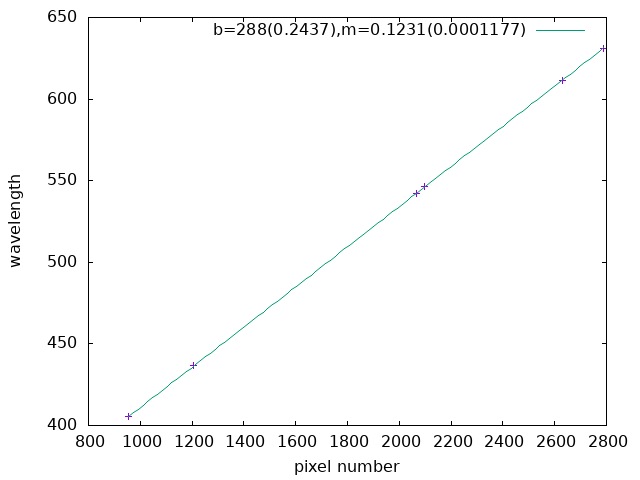
Python/Calibration2/Calibration.png
