drmcnelson/TCD1304-Sensor-Device-with-Linear-Response-and-16-Bit-Differential-ADC/TCD1304_Analog/TCD1304_Analog.pdf

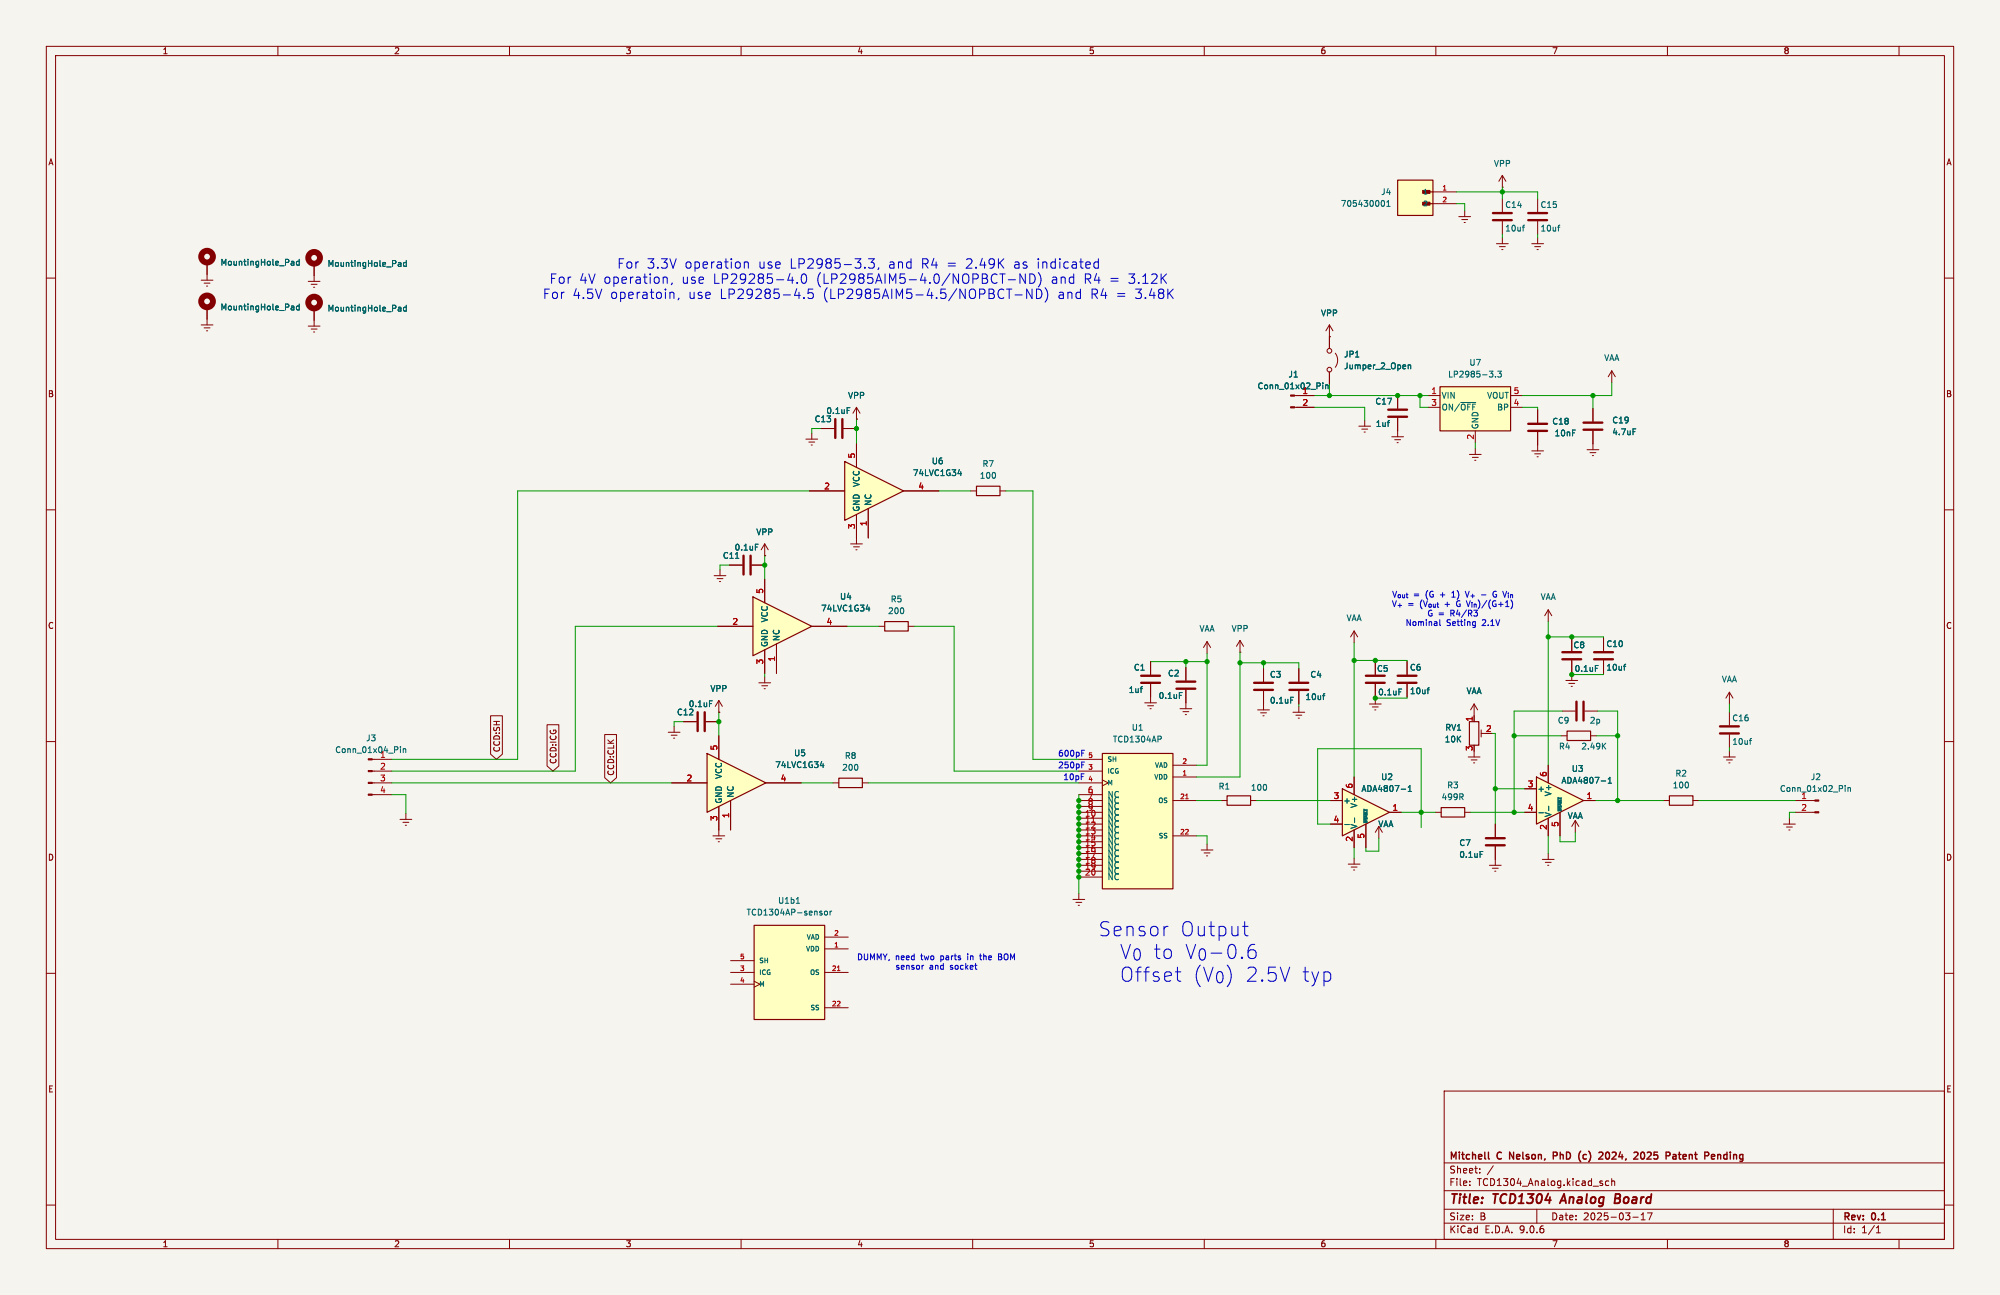
[picture p129: page 1]

V_{+}= (V_{out}+ G V_{in})/(G+1) G = R4/R3 Nominal Setting 2.1V
0.1uF VAA U3 ADA4807-1 +
0.1uF VAA RV1

DUMMY, need two parts in the BOM

Id: 1/1 Title: TCD1304 Analog Board
