drmcnelson/TCD1304-Sensor-Device-with-Linear-Response-and-16-Bit-Differential-ADC/TCD1304_SPI_Rev2EB/TCD1304_SPI_Sch.pdf

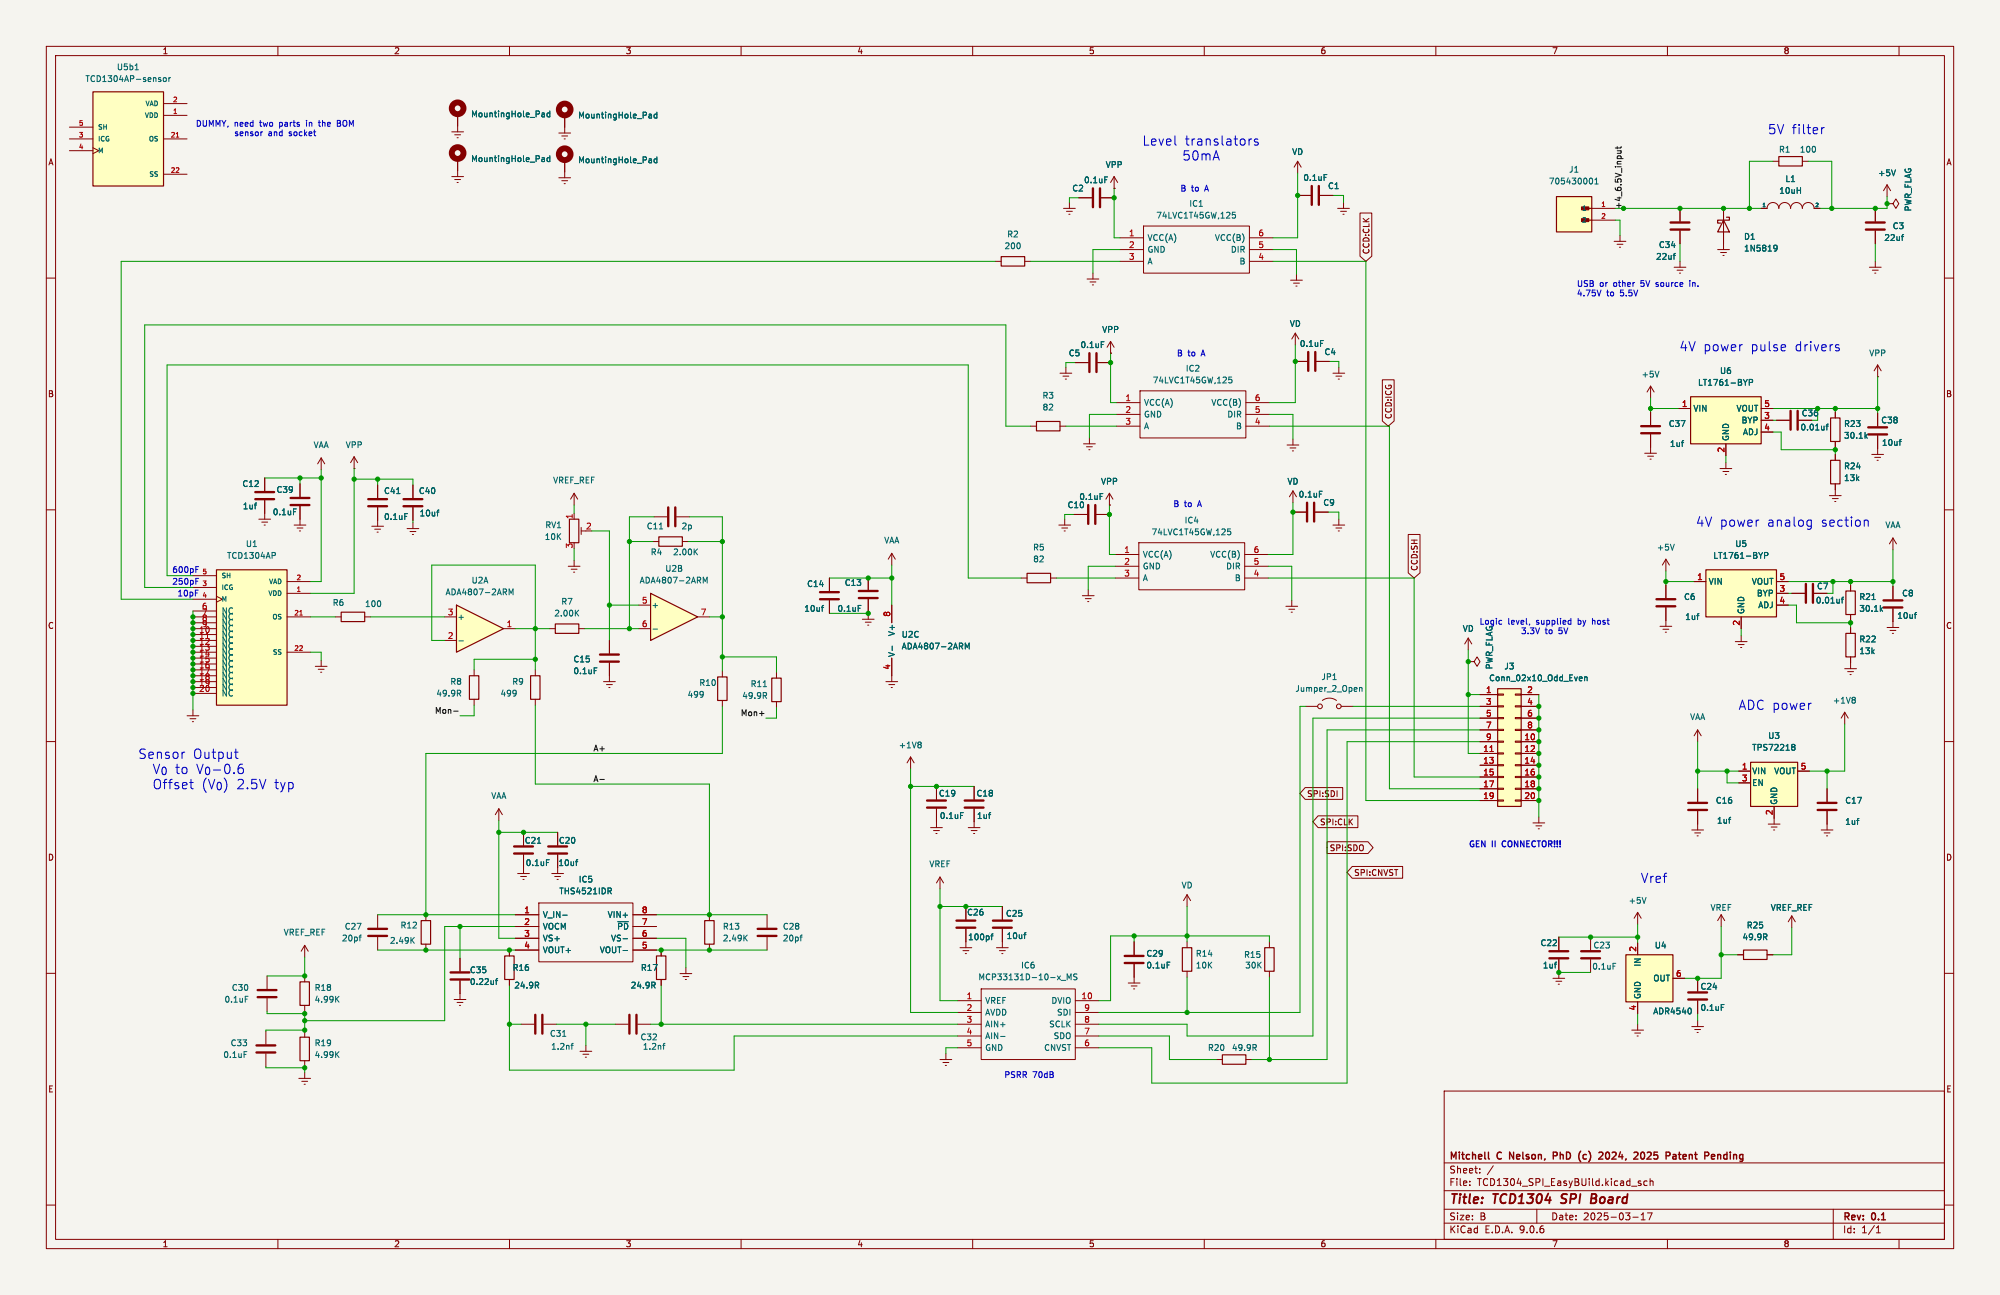
[picture p130: page 1]

B to A DUMMY, need two parts in the BOM

SPI:SDI SPI:SDO CCD:CLK

USB or other 5V source in. 4.75V to 5.5V

Id: 1/1 Title: TCD1304 SPI Board
