drmcnelson/TCD1304-Sensor-Device-with-Linear-Response-and-16-Bit-Differential-ADC/TCD1304_All-In-One_FlexPWM/TCD1304_All-in-One.pdf

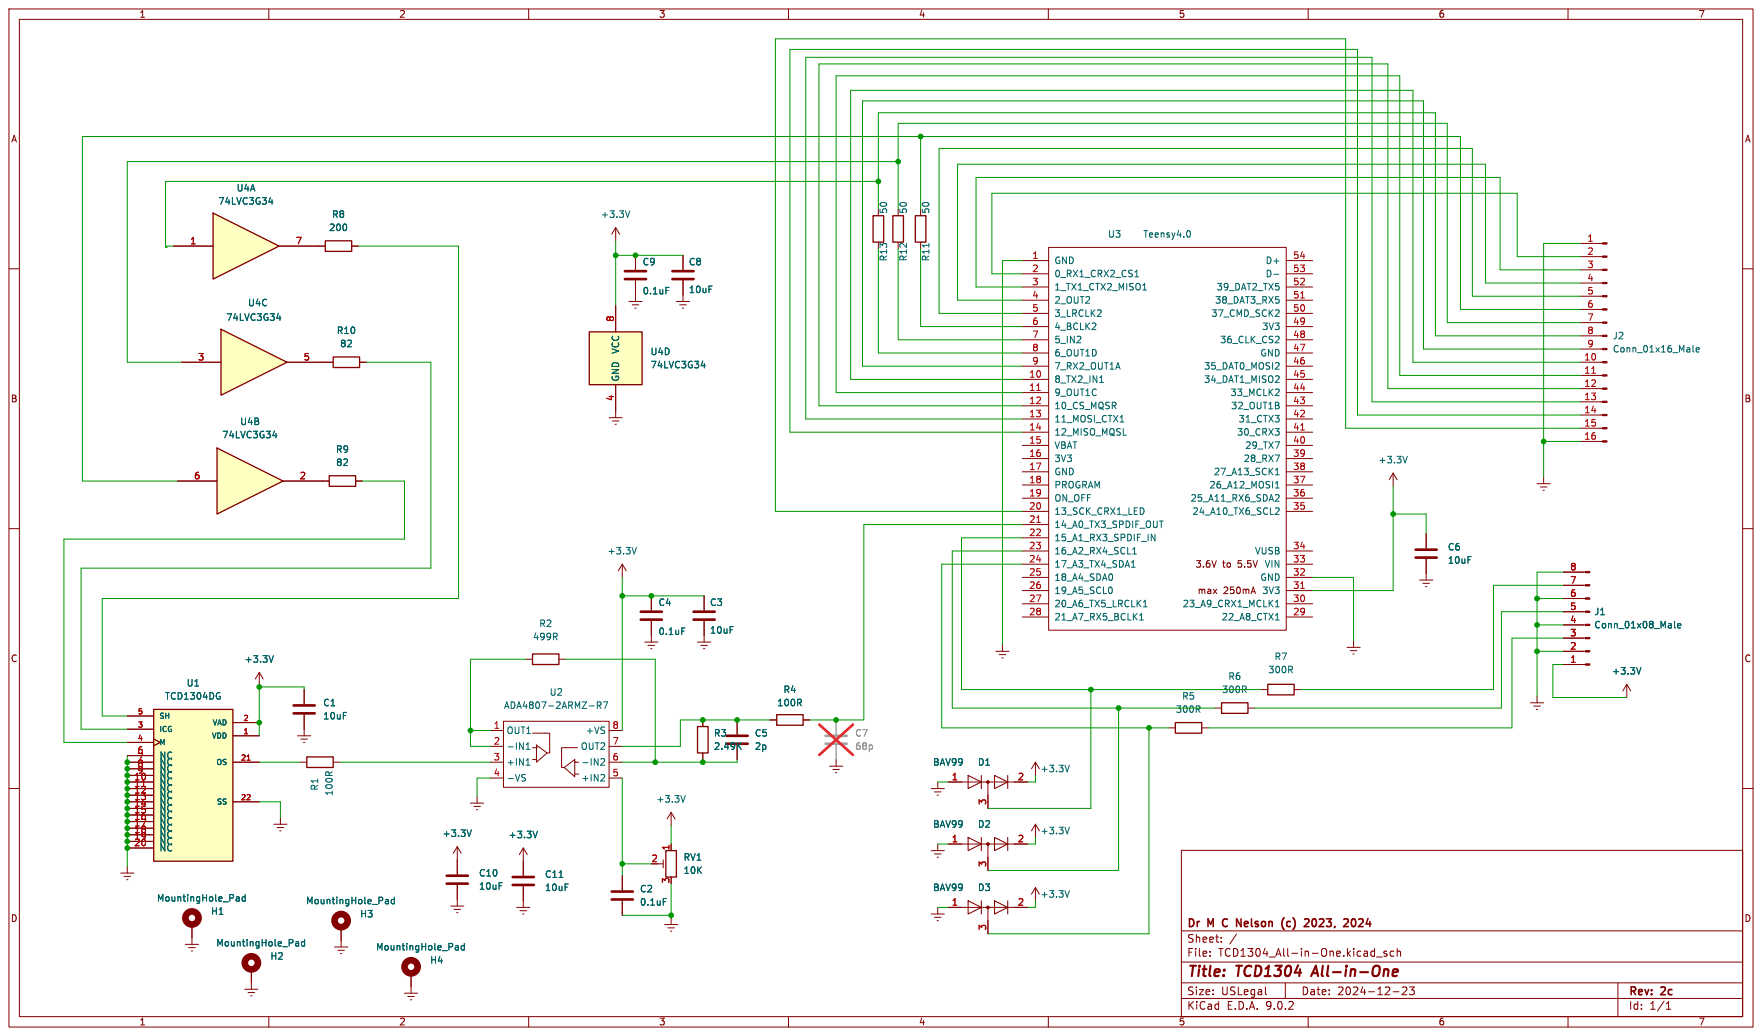
[picture p131: page 1]

Id: 1/1 Title: TCD1304 All-in-One
