drmcnelson/TCD1304-Sensor-Device-with-Linear-Response-and-16-Bit-Differential-ADC/SPICE/Spectrum_Flip_Shift_RC_SAR.asc

C1: cap; 45p
C2: cap; 2n
R1: res; 20
R2: res; 1G
R3: res; 100
R4: res; 1k
R5: res; 1k
S1: sw
U1: ADA4807
U2: ADA4807
V1: voltage; PULSE(0 1 688n 2n 2n 312n 1u 4000)
V2: voltage; PWL file=Fl_0.02s.txt
V3: voltage; 5
V4: voltage; 1.25
Named nets: 0, SAR_CAP, Vc, INPUT, IN-, OUTPUT, IN+, SMPL
.tran 4E-3
.model SW SW(Ron=40 Roff=1G Vt=.5 Vh=-.4
Invert and shift
Sensor output
