drmcnelson/TCD1304-Sensor-Device-with-Linear-Response-and-16-Bit-Differential-ADC/SPICE/Follower_RC_ADC_sine.asc

C1: cap; 31p
C2: cap; 1n
R1: res; 50
R2: res; 1G
R3: res; 100
S1: sw
U2: ADA4807
V1: voltage; PULSE(0 1 688n 2n 2n 312n 1u 24)
V2: voltage; SINE(2.5 2 250K 1u 0 0 2)
V3: voltage; 5
Named nets: 0, SAR_CAP, Vc, INPUT, ADC_IN, SMPL, Ain+, OUT
.tran 0 10E-6 0 1.E-10
.model SW SW(Ron=40 Roff=1G Vt=.5 Vh=-.4)
Sensor output
