drmcnelson/TCD1304-Sensor-Device-with-Linear-Response-and-16-Bit-Differential-ADC/SPICE/TCD1304DifferentialBuffer.asc

A1: inv
C1: cap; 0.1µ
C2: cap; 1.2n
C3: cap; 1.2n
C4: cap; 20p
C5: cap; 20p
C6: cap; 2.2p
C9: cap; 31p
C10: cap; 31p
C11: cap; 2p
C12: cap; 2p
R1: res; 2.00K
R2: res; 2.00K
R3: res; 2.1K
R4: res; 2.2k
R5: res; 0
R6: res; 0
R7: res; 499
R8: res; 499
R9: res; 2.5k
R10: res; 2.5k
R11: res; 22
R12: res; 22
R13: res; 100
S1: sw
S2: sw
S3: sw
S4: sw
U1: ADA4807
U2: ADA4807
U3: AD8137
V1: voltage; PULSE(2.5 1.9 2E-6 1e-8 1e-8 2.E-6 4e-6 3); Rser=500
V3: voltage; 2
V4: voltage; 4.3
V5: voltage; PULSE(0 1 1.6e-6 2n 2n 300n 2.e-6 20)
Named nets: P4V, 0, VCM, vsens_n, vsens_p, adc_inp, adc_inn, CLOCK, Cs+, Cs-, sensor
CCD ouput pulse
.tran 0 20e-6 0
Sensor Bd.
Assume Vref=4V
ADC input
.model SW SW(Ron=200 Roff=1G Vt=.5 Vh=-.4
Use THS4521
