drmcnelson/TCD1304-Sensor-Device-with-Linear-Response-and-16-Bit-Differential-ADC/(commit log)

2025-07-27 Updated Gerbers
2025-08-20 Add Files for the Linear All In One
    [TCD1304_All-in-One_FlexPWM_BOM.xls]
2025-08-20 Add files to buld the Linear TCD1304 Sensor board
    [TCD1304_SPI_Rev2EB_BOM250620.xls]
2025-08-20 Add Arduino Source Codes for T4 Controller R3
2025-11-12 Beta version
    This is now the official Beta version. New stuff: We have the high level command set and a first pass testing the commands. The flexpwm library is reorganized and the legacy prototyping routines are removed. And, we are switching over to our new convention for the command line parsing library. If you find any issues please direct message or email me.
    [TCD1304Device2.h, parselib2.cpp, parselib2.h]
2025-11-13 Beta, update
    Add alerts for dropped frames.
2025-11-13 Beta, update
    Add support for setting pin mode to pulldown, and init clk, sh for pulldown and icg for pullup.
2025-11-14 More efficient binary transfer
    This brackets the binary transfer with flush.
2025-11-28 Ring buffered version of the TCD1304 firmware
    This is an experimental version of the firmware using ring buffering and the callback hook povided by the device library.
2025-11-28 Add new firmware and current component costs
2025-12-02 Add schematic
2025-12-18 Add Analog Board files
    [TCD1304_Analog_BOM.xls]
2025-12-24 Change R7 to 82 ohms
    [TCD1304_Analog_BOM.xls]
2025-12-24 Updates for charge clearance, data and graphics
2025-12-26 R7 100ohm
    For a 5V drive, 100ohm limits the pulse to 50mA.
    [TCD1304_Analog_BOM.xls]
2026-01-06 Further data on residual charge mitigation
2026-04-23 On Residual Charge Physics and Mitigation
2026-04-23 Deterministic model for residual charge and mitigation
2026-04-23 Model for residual charge effects and mitigation
2026-04-23 Update for residual charge and mitigation
2026-04-23 Details, residual charge effects and mitigation
2026-04-23 Residual charge and effective mitigation
2026-04-23 Residual charge physics and effective mitigation
2026-04-23 Residual charge physics and mitigation
2026-04-23 Residual charge physics (ghosting) and mitigation
2026-04-23 Residual charge physics and elimination of the ghost image
2026-04-23 Residual charge physics and eliminating the "ghost"
2026-04-29 Readme Update - additional material
